YeeChanyang98/A-design-of-Air-separation-control-system/(list of files, cad)

Other CAD files:
final project（chinese Ver）/机柜设计.dwg
final project（chinese Ver）/机柜设计CAD2010版.dxf
