YeeChanyang98/A-design-of-Air-separation-control-system/final project（chinese Ver）/机柜设计(1).pdf

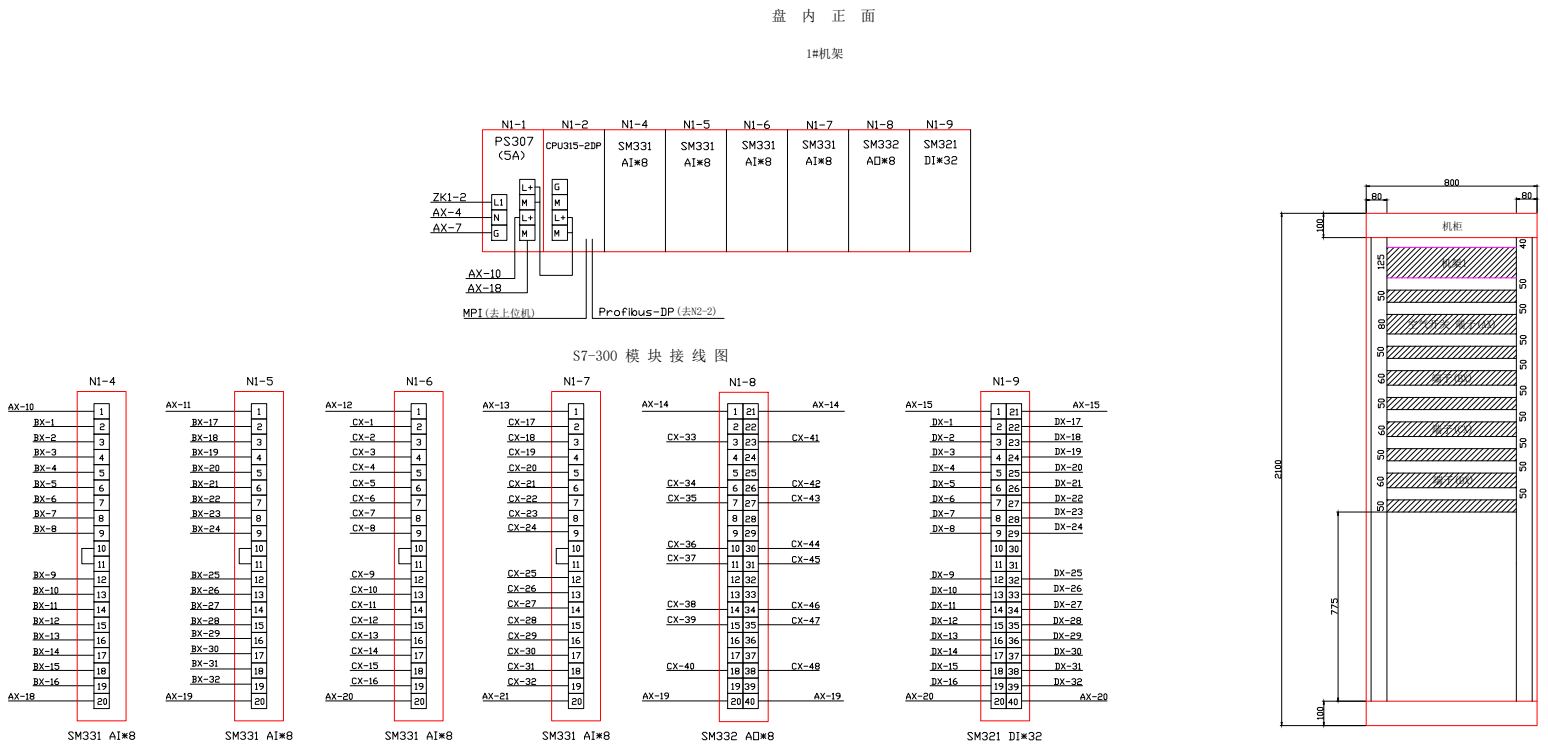
[picture p33: page 1]
机柜机架1 空气开关 端子(AX) 端子(BX) 端子(CX) 端子(DX) 1#机架 盘 内 正 面 S7-300 模 块 接 线 图

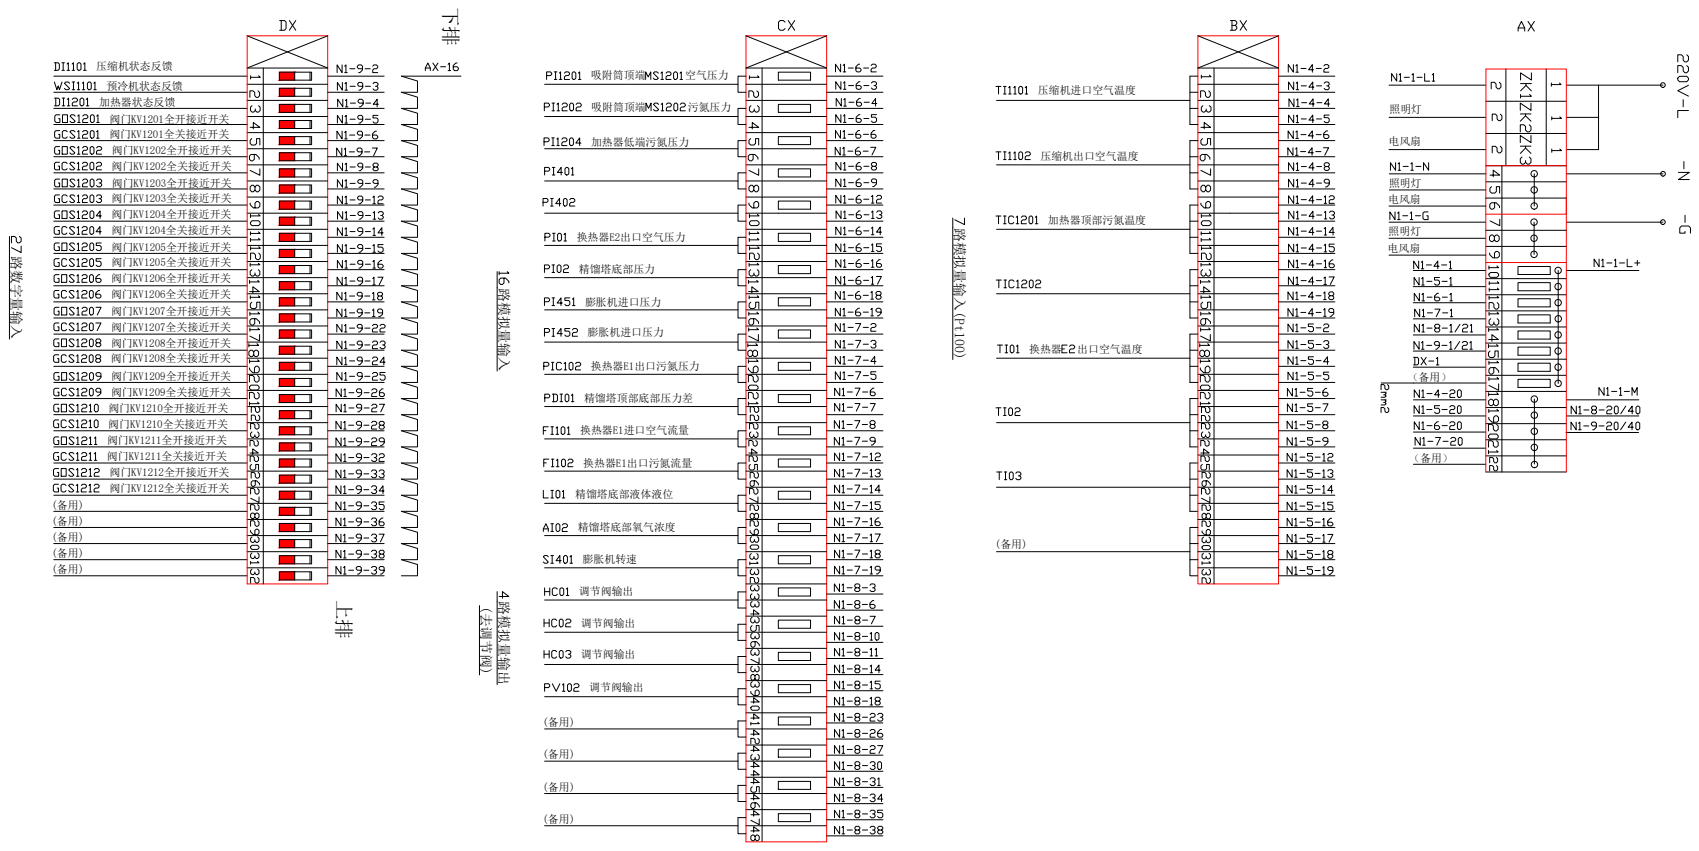
[picture p34: page 2]
照明灯 照明灯（备用） 压缩机进口空气温度 压缩机出口空气温度 加热器顶部污氮温度 换热器; 出口空气温度 吸附筒顶端; 空气压力 吸附筒顶端; 污氮压力 加热器低端污氮压力 换热器E2出口空气压力 精馏塔底部压力 膨胀机进口压力 膨胀机进口压力 换热器E1出口污氮压力 精馏塔顶部底部压力差 换热器E1进口空气流量 换热器E1出口污氮流量 精馏塔底部液体液位 精馏塔底部氧气浓度 膨胀机转速 调节阀输出 调节阀输出 调节阀输出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

路数字量输入 照明灯 电风扇 电风扇 电风扇 (备用) (备用) (备用) (备用) (备用) (备用) (备用) (备用) (备用) (备用)

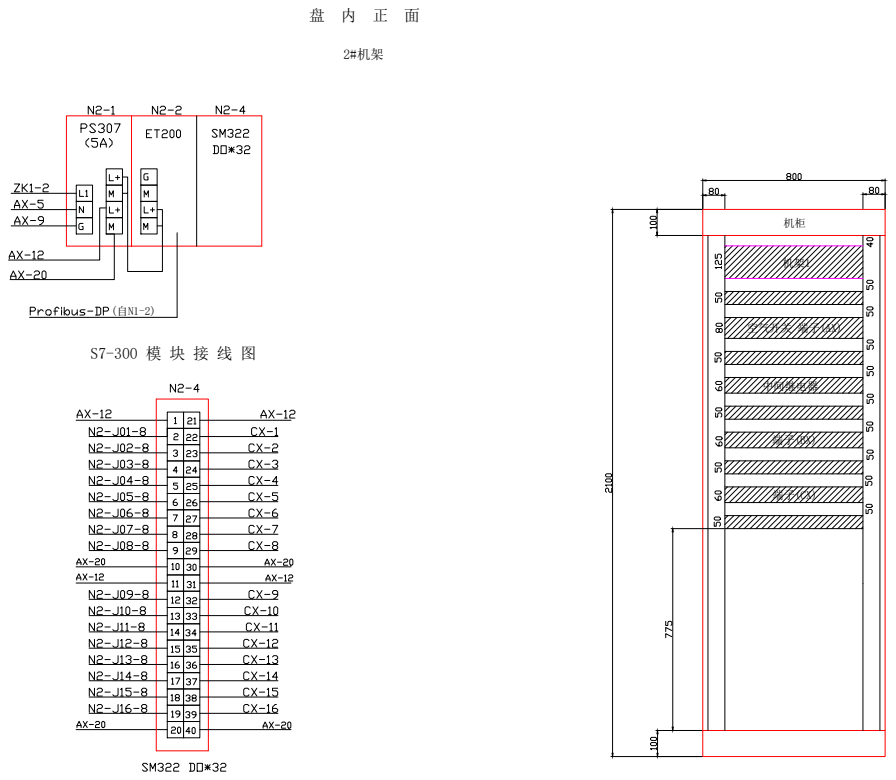
[picture p35: page 3]
机柜机架1 空气开关 端子(AX) 中间继电器 2#机架 盘 内 正 面 S7-300 模 块 接 线 图

(备用) 个小型继电器（两个备用） C1#现场柜 盘 内 正 面 端子(BX) 去现场柜

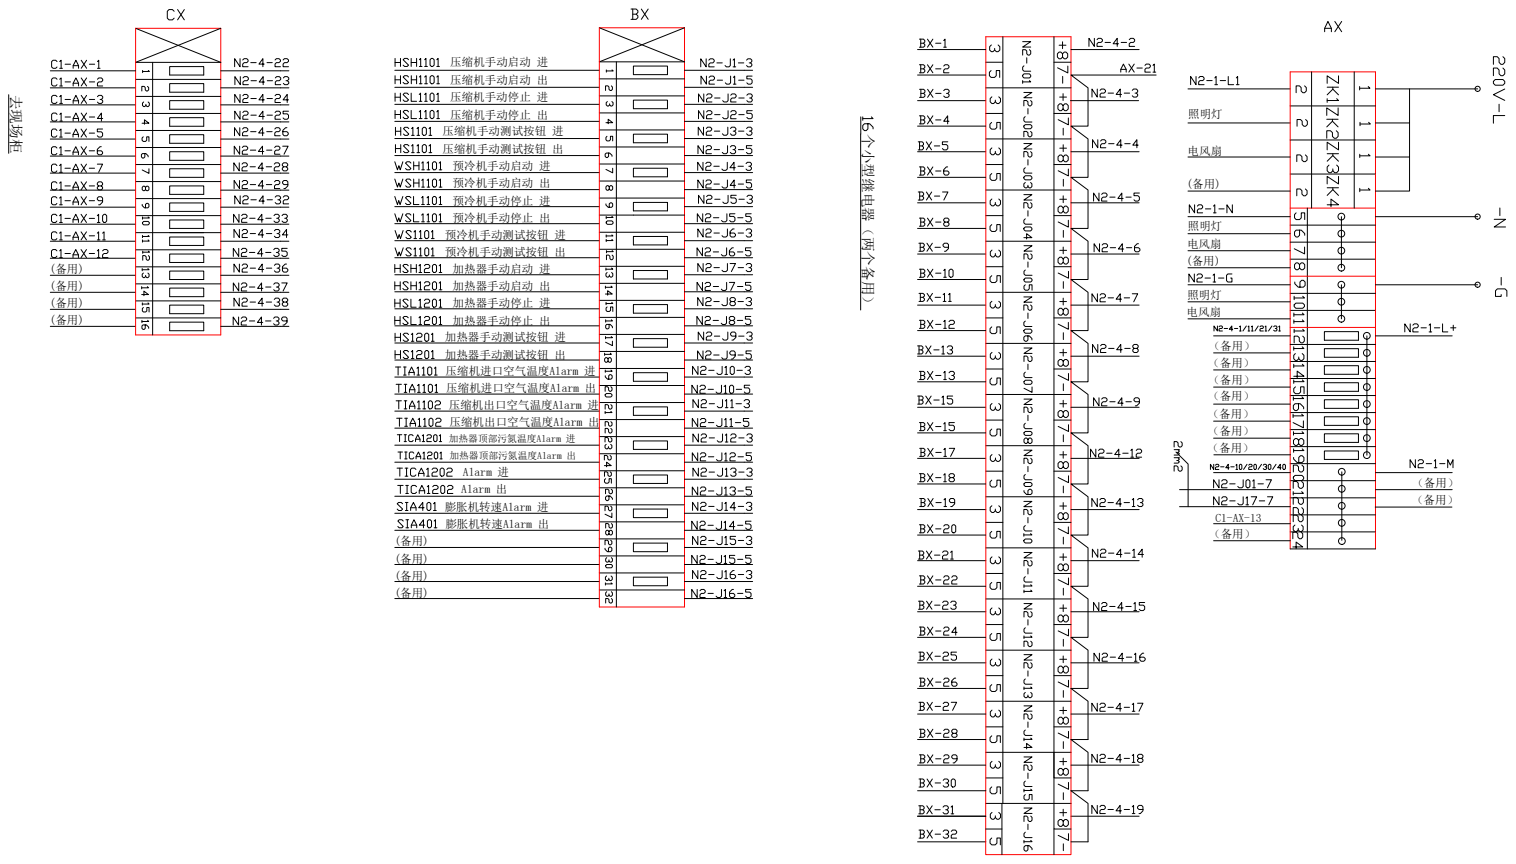
[picture p36: page 4]
照明灯 照明灯 照明灯（备用） （备用） （备用） （备用） （备用） （备用） （备用） （备用）; 压缩机手动启动 进 压缩机手动启动 出 压缩机手动停止 进 压缩机手动停止 出 压缩机手动测试按钮 进 压缩机手动测试按钮 出 预冷机手动启动 进 预冷机手动启动 出 预冷机手动停止 进 预冷机手动停止 出 预冷机手动测试按钮 进 预冷机手动测试按钮 出 加热器手动启动 进 加热器手动启动 出 加热器手动停止 进 加热器手动停止 出 加热器手动测试按钮 进 加热器手动测试按钮 出 压缩机进口空气温度Alarm 进 压缩机进口空气温度Alarm 出 压缩机出口空气温度Alarm 进 压缩机出口空气温度Alarm 出 加热器顶部污氮温度Alarm 进 加热器顶部污氮温度Alarm 出 Alarm 进 Alarm 出 膨胀机转速Alarm 进 膨胀机转速Alarm 出; 电风扇 电风扇 (备用) 电风扇 (备用) (备用) (备用) (备用) (备用)

去现场柜 (备用) (备用) (备用) (备用)

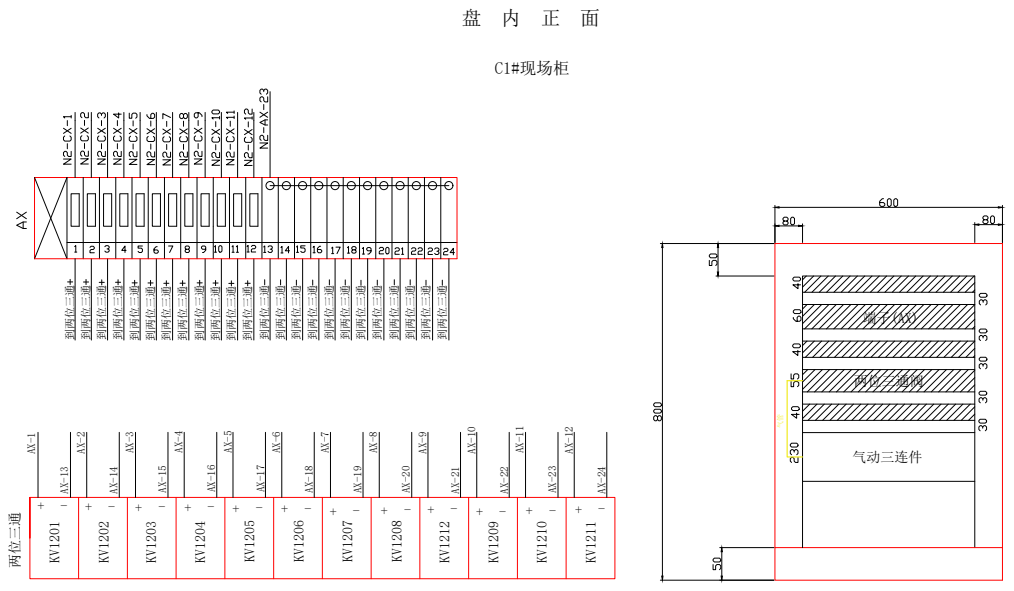
[picture p37: page 5]
两位三通+ - + - + - + - + - + - + - + - + - + - + - + -; KV1211 C1#现场柜 盘 内 正 面

端子(AX) 两位三通阀 气动三连件
